ja-ko/fusioncore/slave/README.md

# Hello World Example

Starts a FreeRTOS task to print "Hello World"

See the README.md file in the upper level 'examples' directory for more information about examples.
