ja-ko/fusioncore/pcb/fusioncore.pdf

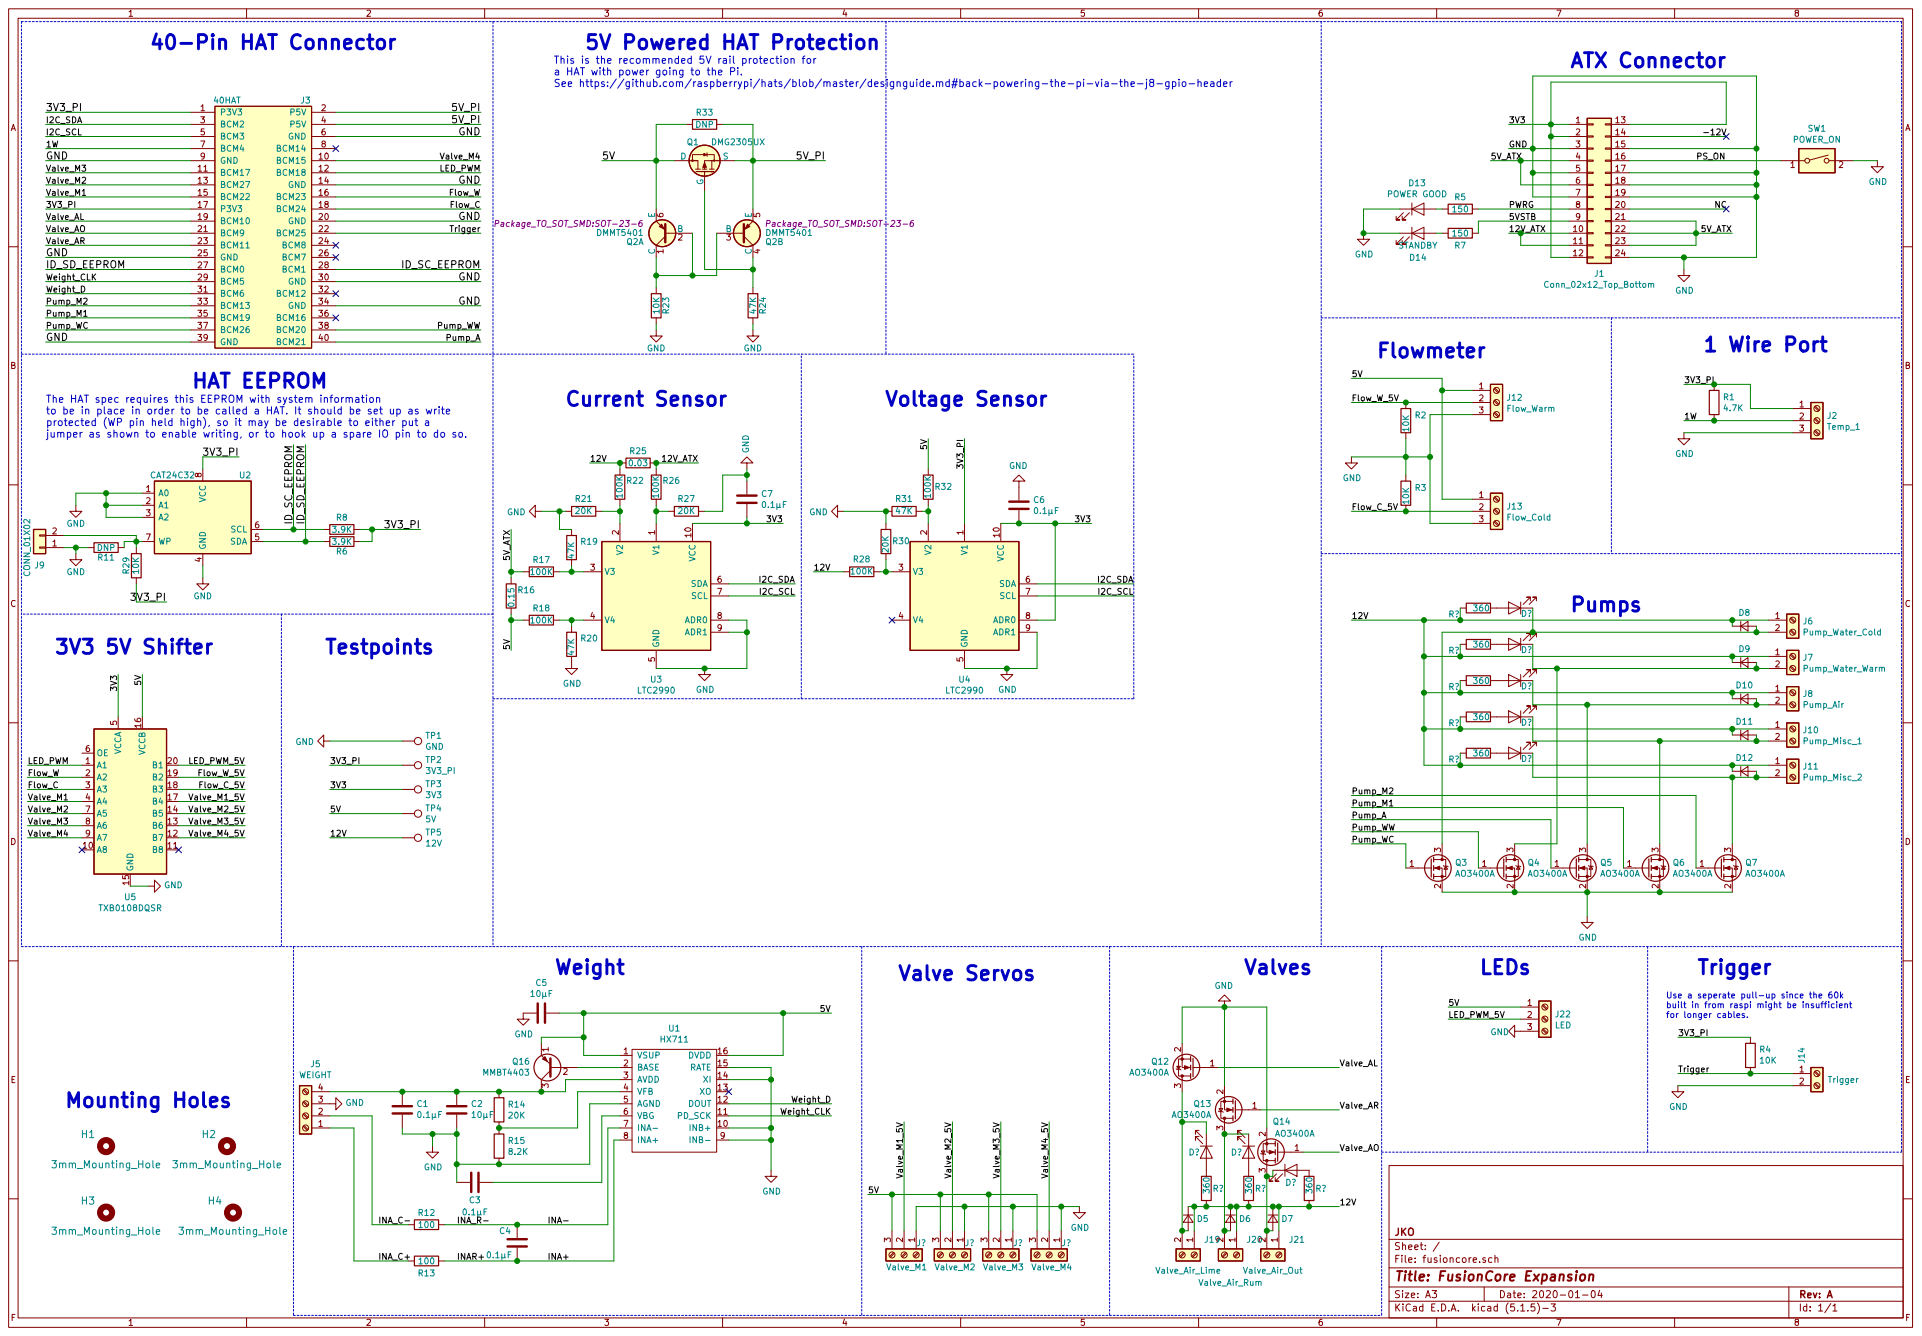
[picture p1: page 1]

This is the recommended 5V rail protection for
a HAT with power going to the Pi.
See https://github.com/raspberrypi/hats/blob/master/designguide.md#back-powering-the-pi-via-the-j8-gpio-header

The HAT spec requires this EEPROM with system information
to be in place in order to be called a HAT. It should be set up as write
protected (WP pin held high), so it may be desirable to either put a
jumper as shown to enable writing, or to hook up a spare IO pin to do so.

Use a seperate pull-up since the 60k
built in from raspi might be insufficient
for longer cables.
Trigger 3V3_PI

File: fusioncore.sch Sheet: / JKO

Id: 1/1 Title: FusionCore Expansion
