ja-ko/fusioncore/pcb/fusioncore.kicad_pcb

## KiCad design pcb/fusioncore.kicad_pcb (2020-06-07)

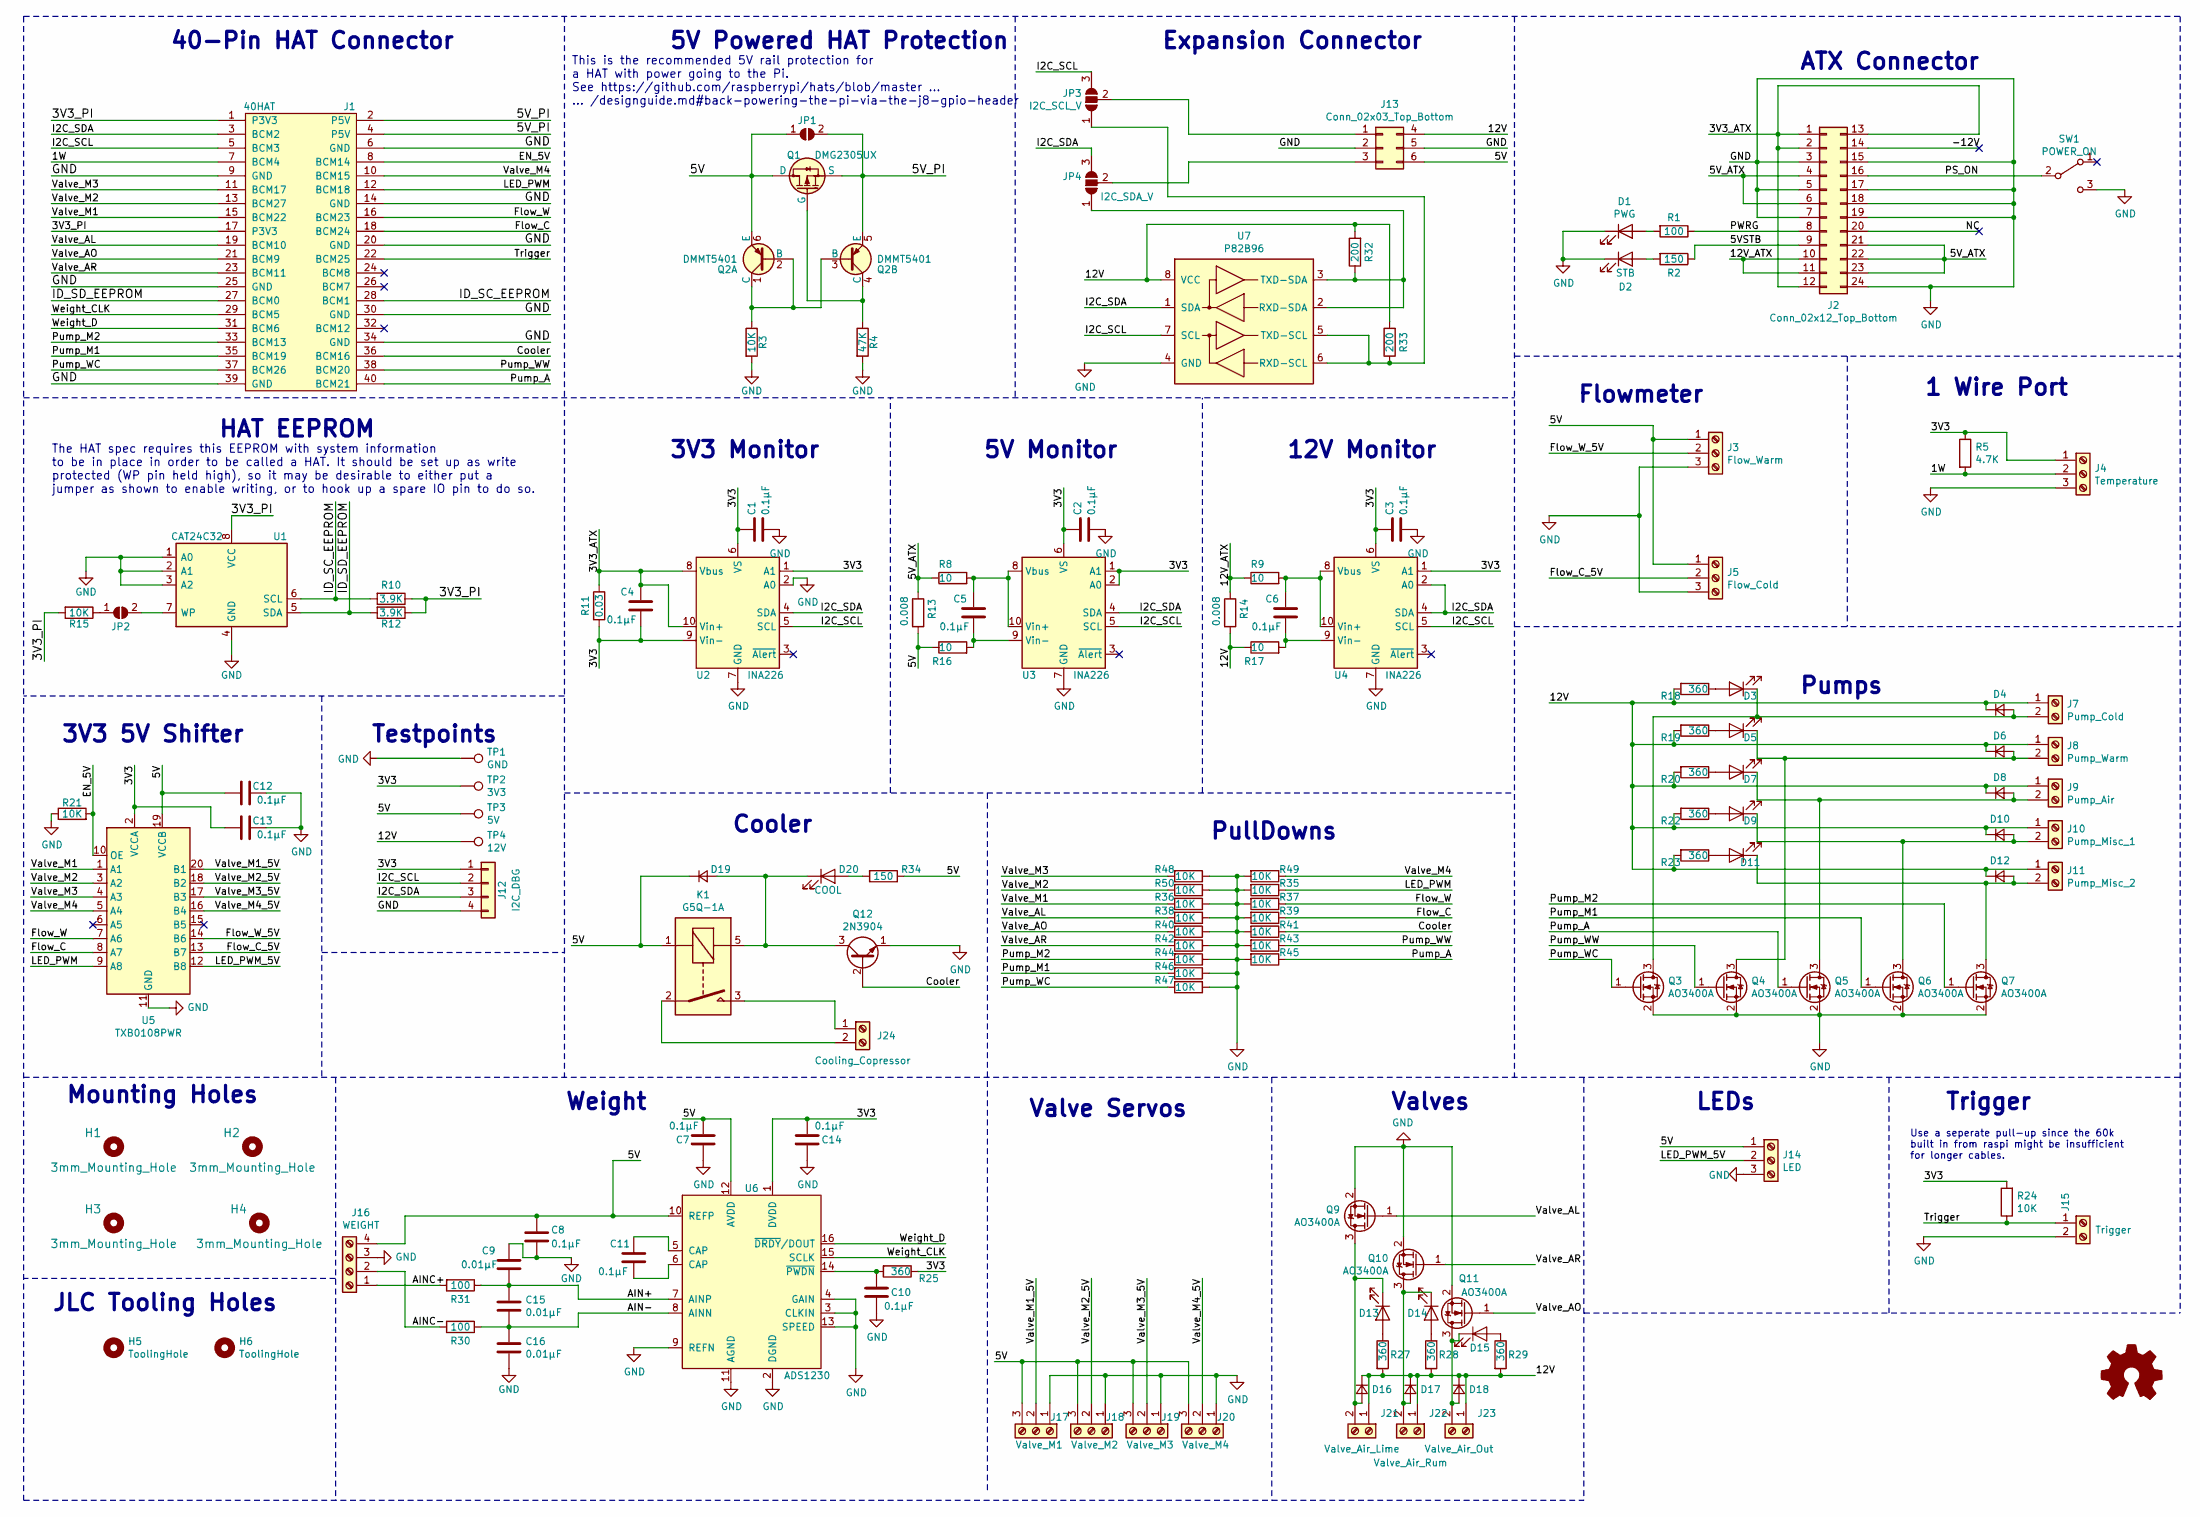
[picture p2: schematic fusioncore.sch, FusionCore Expansion]

Parts:
C1, C2, C3, C4, C5, C6, C7, C8, C10, C11, C12, C13, C14: 0.1μF; C_0805_2012Metric_Pad1.15x1.40mm_HandSolder; LCSC C49678
C9, C15, C16: 0.01μF; C_0402_1005Metric; LCSC C15195
D1: PWG; LED_0603_1608Metric_Pad1.05x0.95mm_HandSolder; LCSC C72043
D2: STB; LED_0805_2012Metric_Pad1.15x1.40mm_HandSolder; LCSC C2296
D3, D5, D7, D9, D11, D13, D14, D15: LED; LED_0603_1608Metric_Pad1.05x0.95mm_HandSolder; LCSC C72041
D4, D6, D8, D10, D12: D_Small; D_SMA; LCSC C22452
D16, D17, D18, D19: D; D_SMA; LCSC C22452
D20: COOL; LED_0805_2012Metric_Pad1.15x1.40mm_HandSolder; LCSC C2296
H1, H2, H3, H4: 3mm_Mounting_Hole; NPTH_3mm_ID
H5, H6: ToolingHole; JLC_Tooling_Hole
J1: 40HAT; PinSocket_2x20_P2.54mm_Vertical; Digikey 952-2150-ND‎
J2: Conn_02x12_Top_Bottom; Molex_Mini-Fit_Jr_5566-24A_2x12_P4.20mm_Vertical; Digikey WM3811-ND‎
J3: Flow_Warm; TerminalBlock_Phoenix_PT-1,5-3-5.0-H_1x03_P5.00mm_Horizontal; Digikey 277-1578-ND‎
J4: Temperature; TerminalBlock_Phoenix_PT-1,5-2-3.5-H_1x03_P3.50mm_Diagonal; Digikey 277-1780-ND
J5: Flow_Cold; TerminalBlock_Phoenix_PT-1,5-3-5.0-H_1x03_P5.00mm_Horizontal; Digikey 277-1578-ND‎
J7: Pump_Cold; TerminalBlock_Phoenix_PT-1,5-2-5.0-H_1x02_P5.00mm_Horizontal; Digikey 277-1667-ND
J8: Pump_Warm; TerminalBlock_Phoenix_PT-1,5-2-5.0-H_1x02_P5.00mm_Horizontal; Digikey 277-1667-ND
J9: Pump_Air; TerminalBlock_Phoenix_PT-1,5-2-5.0-H_1x02_P5.00mm_Horizontal; Digikey 277-1667-ND
J10: Pump_Misc_1; TerminalBlock_Phoenix_PT-1,5-2-5.0-H_1x02_P5.00mm_Horizontal; Digikey 277-1667-ND
J11: Pump_Misc_2; TerminalBlock_Phoenix_PT-1,5-2-5.0-H_1x02_P5.00mm_Horizontal; Digikey 277-1667-ND
J12: I2C_DBG; PinHeader_1x04_P2.54mm_Vertical; Digikey 732-5317-ND
J13: Conn_02x03_Top_Bottom; Molex_Micro-Fit_3.0_43045-0612_2x03_P3.00mm_Vertical; Digikey WM1791-ND
J14: LED; TerminalBlock_Phoenix_PT-1,5-3-5.0-H_1x03_P5.00mm_Horizontal; Digikey 277-1578-ND‎
J15: Trigger; TerminalBlock_Phoenix_PT-1,5-2-3.5-H_1x02_P3.50mm_Diagonal; Digikey 277-1779-ND
J16: WEIGHT; TerminalBlock_Phoenix_PT-1,5-4-5.0-H_1x04_P5.00mm_Horizontal
J17: Valve_M1; TerminalBlock_Phoenix_PT-1,5-3-5.0-H_1x03_P5.00mm_Horizontal; Digikey 277-1578-ND‎
J18: Valve_M2; TerminalBlock_Phoenix_PT-1,5-3-5.0-H_1x03_P5.00mm_Horizontal; Digikey 277-1578-ND‎
J19: Valve_M3; TerminalBlock_Phoenix_PT-1,5-3-5.0-H_1x03_P5.00mm_Horizontal; Digikey 277-1578-ND‎
J20: Valve_M4; TerminalBlock_Phoenix_PT-1,5-3-5.0-H_1x03_P5.00mm_Horizontal; Digikey 277-1578-ND‎
J21: Valve_Air_Lime; TerminalBlock_Phoenix_PT-1,5-2-5.0-H_1x02_P5.00mm_Horizontal; Digikey 277-1667-ND
J22: Valve_Air_Rum; TerminalBlock_Phoenix_PT-1,5-2-5.0-H_1x02_P5.00mm_Horizontal; Digikey 277-1667-ND
J23: Valve_Air_Out; TerminalBlock_Phoenix_PT-1,5-2-5.0-H_1x02_P5.00mm_Horizontal; Digikey 277-1667-ND
J24: Cooling_Copressor; TerminalBlock_Phoenix_PT-1,5-2-5.0-H_1x02_P5.00mm_Horizontal
JP1, JP2: SolderJumper_2_Open; SolderJumper-2_P1.3mm_Open_Pad1.0x1.5mm
JP3: I2C_SCL_V; SolderJumper-3_P1.3mm_Open_Pad1.0x1.5mm
JP4: I2C_SDA_V; SolderJumper-3_P1.3mm_Open_Pad1.0x1.5mm
K1: G5Q-1A; Relay_SPST_Omron-G5Q-1A; Digikey ‎Z6367-ND‎
Q1: DMG2305UX; SOT-23; LCSC C144153
Q2: DMMT5401; SOT-23-6_Handsoldering; LCSC C154733
Q3, Q4, Q5, Q6, Q7, Q9, Q10, Q11: AO3400A; SOT-23; LCSC C20917
Q12: 2N3904; SOT-23; LCSC C18536
R1, R30, R31: 100; R_0805_2012Metric_Pad1.15x1.40mm_HandSolder; LCSC C17408
R2, R34: 150; R_0805_2012Metric_Pad1.15x1.40mm_HandSolder; LCSC C17471
R3, R15, R21, R24: 10K; R_0805_2012Metric_Pad1.15x1.40mm_HandSolder; LCSC C17414
R4: 47K; R_0805_2012Metric_Pad1.15x1.40mm_HandSolder; LCSC C17713
R5: 4.7K; R_0805_2012Metric_Pad1.15x1.40mm_HandSolder; LCSC C17673
R8, R9, R16, R17: 10; R_0805_2012Metric_Pad1.15x1.40mm_HandSolder; LCSC C17415
R10, R12: 3.9K; R_0805_2012Metric_Pad1.15x1.40mm_HandSolder; LCSC C17614
R11: 0.03; R_0805_2012Metric_Pad1.15x1.40mm_HandSolder; LCSC C247605
R13, R14: 0.008; R_2512_6332Metric_Pad1.52x3.35mm_HandSolder; LCSC C76241
R18, R19, R20, R22, R23, R25, R27, R28, R29: 360; R_0603_1608Metric_Pad1.05x0.95mm_HandSolder; LCSC C25194
R32, R33: 200; R_0805_2012Metric_Pad1.15x1.40mm_HandSolder; LCSC C17540
R35, R36, R37, R38, R39, R40, R41, R42, R43, R44, R45, R46, R47, R48, R49, R50: 10K; R_0402_1005Metric; LCSC C25744
SW1: POWER_ON; SW_CuK_JS202011CQN_DPDT_Straight; Digikey 401-2001-ND
TP1: GND; TestPoint_THTPad_D2.0mm_Drill1.0mm
TP2: 3V3; TestPoint_THTPad_D2.0mm_Drill1.0mm
TP3: 5V; TestPoint_THTPad_D2.0mm_Drill1.0mm
TP4: 12V; TestPoint_THTPad_D2.0mm_Drill1.0mm
U1: CAT24C32; SOIC-8_3.9x4.9mm_P1.27mm; LCSC C81193
U2, U3, U4: INA226; VSSOP-10_3x3mm_P0.5mm; LCSC C49851
U5: TXB0108PWR; TSSOP-20_4.4x6.5mm_P0.65mm; LCSC C53406
U6: ADS1230; TSSOP-16_4.4x5mm_P0.65mm; LCSC C58052
U7: P82B96; SOIC-8_3.9x4.9mm_P1.27mm; LCSC C32103

Connections:
/1W: J1.7 (BCM4), J4.2, R5.2
/3V3: C1.2, C2.2, C3.2, C4.1, C13.2, C14.2, J4.1, J12.1, R5.1, R11.2, R24.2, R25.1, TP2.1, U2.1 (A1), U2.6 (VS), U2.9 (Vin-), U3.1 (A1), U3.2 (A0), U3.6 (VS), U4.1 (A1), U4.6 (VS), U5.2 (VCCA), U6.1 (DVDD)
/3V3_ATX: C4.2, J2.1, J2.2, J2.12, J2.13, R11.1, U2.8 (Vbus), U2.10 (Vin+)
/3V3_PI: J1.1 (P3V3), J1.17 (P3V3), R10.1, R12.1, R15.2, U1.8 (VCC)
/5V: C7.2, C8.2, C12.2, D19.1 (K), J3.1, J5.1, J13.6, J14.1, J16.4, J17.3, J18.3, J19.3, J20.3, JP1.1 (A), K1.1, Q1.3 (D), Q2.6 (E), R13.2, R16.1, R34.1, TP3.1, U5.19 (VCCB), U6.10 (REFP), U6.12 (AVDD)
/5VSTB: J2.9, R2.1
/5V_ATX: J2.4, J2.6, J2.21, J2.22, J2.23, R8.1, R13.1
/5V_PI: J1.2 (P5V), J1.4 (P5V), JP1.2 (B), Q1.2 (S), Q2.5 (E)
/12V: D4.1 (K), D6.1 (K), D8.1 (K), D10.1 (K), D12.1 (K), D16.1 (K), D17.1 (K), D18.1 (K), J7.1, J8.1, J9.1, J10.1, J11.1, J13.4, J21.1, J22.1, J23.1, R14.2, R17.1, R18.2, R19.2, R20.2, R22.2, R23.2, R27.2, R28.2, R29.2, R32.2, R33.2, TP4.1, U7.8 (VCC)
/12V_ATX: J2.10, J2.11, R9.1, R14.1
/AIN+: C9.1, C15.2, R31.1, U6.7 (AINP)
/AIN-: C15.1, C16.2, R30.1, U6.8 (AINN)
/AINC+: J16.1, R31.2
/AINC-: J16.2, R30.2
/Cooler: J1.36 (BCM16), Q12.2 (B), R41.1
/EN_5V: J1.8 (BCM14), R21.2, U5.10 (OE)
/Flow_C: J1.18 (BCM24), R39.1, U5.8 (A7)
/Flow_C_5V: J5.2, U5.13 (B7)
/Flow_W: J1.16 (BCM23), R37.1, U5.7 (A6)
/Flow_W_5V: J3.2, U5.14 (B6)
/I2C_SCL: J1.5 (BCM3), J12.2, JP3.3 (B), U2.5 (SCL), U3.5 (SCL), U4.5 (SCL), U7.7 (SCL)
/I2C_SDA: J1.3 (BCM2), J12.3, JP4.3 (B), U2.4 (SDA), U3.4 (SDA), U4.2 (A0), U4.4 (SDA), U7.1 (SDA)
/ID_SC_EEPROM: J1.28 (BCM1), R10.2, U1.6 (SCL)
/ID_SD_EEPROM: J1.27 (BCM0), R12.2, U1.5 (SDA)
/LED_PWM: J1.12 (BCM18), R35.1, U5.9 (A8)
/LED_PWM_5V: J14.2, U5.12 (B8)
/PS_ON: J2.16, SW1.2 (B)
/PWRG: J2.8, R1.1
/Pump_A: J1.40 (BCM21), Q5.1 (G), R45.1
/Pump_M1: J1.35 (BCM19), Q6.1 (G), R46.2
/Pump_M2: J1.33 (BCM13), Q7.1 (G), R44.2
/Pump_WC: J1.37 (BCM26), Q3.1 (G), R47.2
/Pump_WW: J1.38 (BCM20), Q4.1 (G), R43.1
/Trigger: J1.22 (BCM25), J15.1, R24.1
/Valve_AL: J1.19 (BCM10), Q9.1 (G), R38.2
/Valve_AO: J1.21 (BCM9), Q11.1 (G), R40.2
/Valve_AR: J1.23 (BCM11), Q10.1 (G), R42.2
/Valve_M1: J1.15 (BCM22), R36.2, U5.1 (A1)
/Valve_M1_5V: J17.2, U5.20 (B1)
/Valve_M2: J1.13 (BCM27), R50.2, U5.3 (A2)
/Valve_M2_5V: J18.2, U5.18 (B2)
/Valve_M3: J1.11 (BCM17), R48.2, U5.4 (A3)
/Valve_M3_5V: J19.2, U5.17 (B3)
/Valve_M4: J1.10 (BCM15), R49.1, U5.5 (A4)
/Valve_M4_5V: J20.2, U5.16 (B4)
/Weight_CLK: J1.29 (BCM5), U6.15 (SCLK)
/Weight_D: J1.31 (BCM6), U6.16 (~DRDY~/DOUT)
GND: C1.1, C2.1, C3.1, C7.1, C8.1, C9.2, C10.1, C12.1, C13.1, C14.1, C16.1, D1.1 (K), D2.1 (K), J1.6 (GND), J1.9 (GND), J1.14 (GND), J1.20 (GND), J1.25 (GND), J1.30 (GND), J1.34 (GND), J1.39 (GND), J2.3, J2.5, J2.7, J2.15, J2.17, J2.18, J2.19, J2.24, J3.3, J4.3, J5.3, J12.4, J13.2, J13.5, J14.3, J15.2, J16.3, J17.1, J18.1, J19.1, J20.1, Q3.2 (S), Q4.2 (S), Q5.2 (S), Q6.2 (S), Q7.2 (S), Q9.2 (S), Q10.2 (S), Q11.2 (S), Q12.1 (E), R3.2, R4.2, R21.1, R35.2, R36.1, R37.2, R38.1, R39.2, R40.1, R41.2, R42.1, R43.2, R44.1, R45.2, R46.1, R47.1, R48.1, R49.2, R50.1, SW1.3 (C), TP1.1, U1.1 (A0), U1.2 (A1), U1.3 (A2), U1.4 (GND), U2.2 (A0), U2.7 (GND), U3.7 (GND), U4.7 (GND), U5.11 (GND), U6.2 (DGND), U6.3 (CLKIN), U6.4 (GAIN), U6.9 (REFN), U6.11 (AGND), U6.13 (SPEED), U7.4 (GND)
unnamed: C5.1, R16.2, U3.9 (Vin-)
unnamed: C5.2, R8.2, U3.8 (Vbus), U3.10 (Vin+)
unnamed: C6.1, R17.2, U4.9 (Vin-)
unnamed: C6.2, R9.2, U4.8 (Vbus), U4.10 (Vin+)
unnamed: C10.2, R25.2, U6.14 (~PWDN)
unnamed: C11.1, U6.5 (CAP)
unnamed: C11.2, U6.6 (CAP)
unnamed: D1.2 (A), R1.2
unnamed: D2.2 (A), R2.2
unnamed: D3.1 (K), D4.2 (A), J7.2, Q3.3 (D)
unnamed: D3.2 (A), R18.1
unnamed: D5.1 (K), D6.2 (A), J8.2, Q4.3 (D)
unnamed: D5.2 (A), R19.1
unnamed: D7.1 (K), D8.2 (A), J9.2, Q5.3 (D)
unnamed: D7.2 (A), R20.1
unnamed: D9.2 (A), R22.1
unnamed: D9.1 (K), D10.2 (A), J10.2, Q6.3 (D)
unnamed: D11.1 (K), D12.2 (A), J11.2, Q7.3 (D)
unnamed: D11.2 (A), R23.1
unnamed: D13.1 (K), D16.2 (A), J21.2, Q9.3 (D)
unnamed: D13.2 (A), R27.1
unnamed: D14.1 (K), D17.2 (A), J22.2, Q10.3 (D)
unnamed: D14.2 (A), R28.1
unnamed: D15.1 (K), D18.2 (A), J23.2, Q11.3 (D)
unnamed: D15.2 (A), R29.1
unnamed: D19.2 (A), D20.1 (K), K1.5, Q12.3 (C)
unnamed: D20.2 (A), R34.2
unnamed: J13.1, JP3.2 (C)
unnamed: J13.3, JP4.2 (C)
unnamed: J24.1, K1.3
unnamed: J24.2, K1.2
unnamed: JP2.1 (A), R15.1
unnamed: JP2.2 (B), U1.7 (WP)
unnamed: JP3.1 (A), R33.1, U7.5 (TXD-SCL), U7.6 (RXD-SCL)
unnamed: JP4.1 (A), R32.1, U7.2 (RXD-SDA), U7.3 (TXD-SDA)
unnamed: Q1.1 (G), Q2.4 (C), R4.1
unnamed: Q2.1 (C), Q2.2 (B), Q2.3 (B), R3.1

Notes on the sheet:
5V Powered HAT Protection
This is the recommended 5V rail protection for a HAT with power going to the Pi. See https://github.com/raspberrypi/hats/blob/master ... ... /designguide.md#back-powering-the-pi-via-the-j8-gpio-header
HAT EEPROM
Mounting Holes
40-Pin HAT Connector
The HAT spec requires this EEPROM with system information to be in place in order to be called a HAT. It should be set up as write protected (WP pin held high), so it may be desirable to either put a jumper as shown to enable writing, or to hook up a spare IO pin to do so.
ATX Connector
1 Wire Port
Pumps
Valves
LEDs
Flowmeter
Weight
Use a seperate pull-up since the 60k built in from raspi might be insufficient for longer cables.
Trigger
3V3 Monitor
Testpoints
3V3 5V Shifter
Valve Servos
Expansion Connector
JLC Tooling Holes
5V Monitor
12V Monitor
Cooler
PullDowns

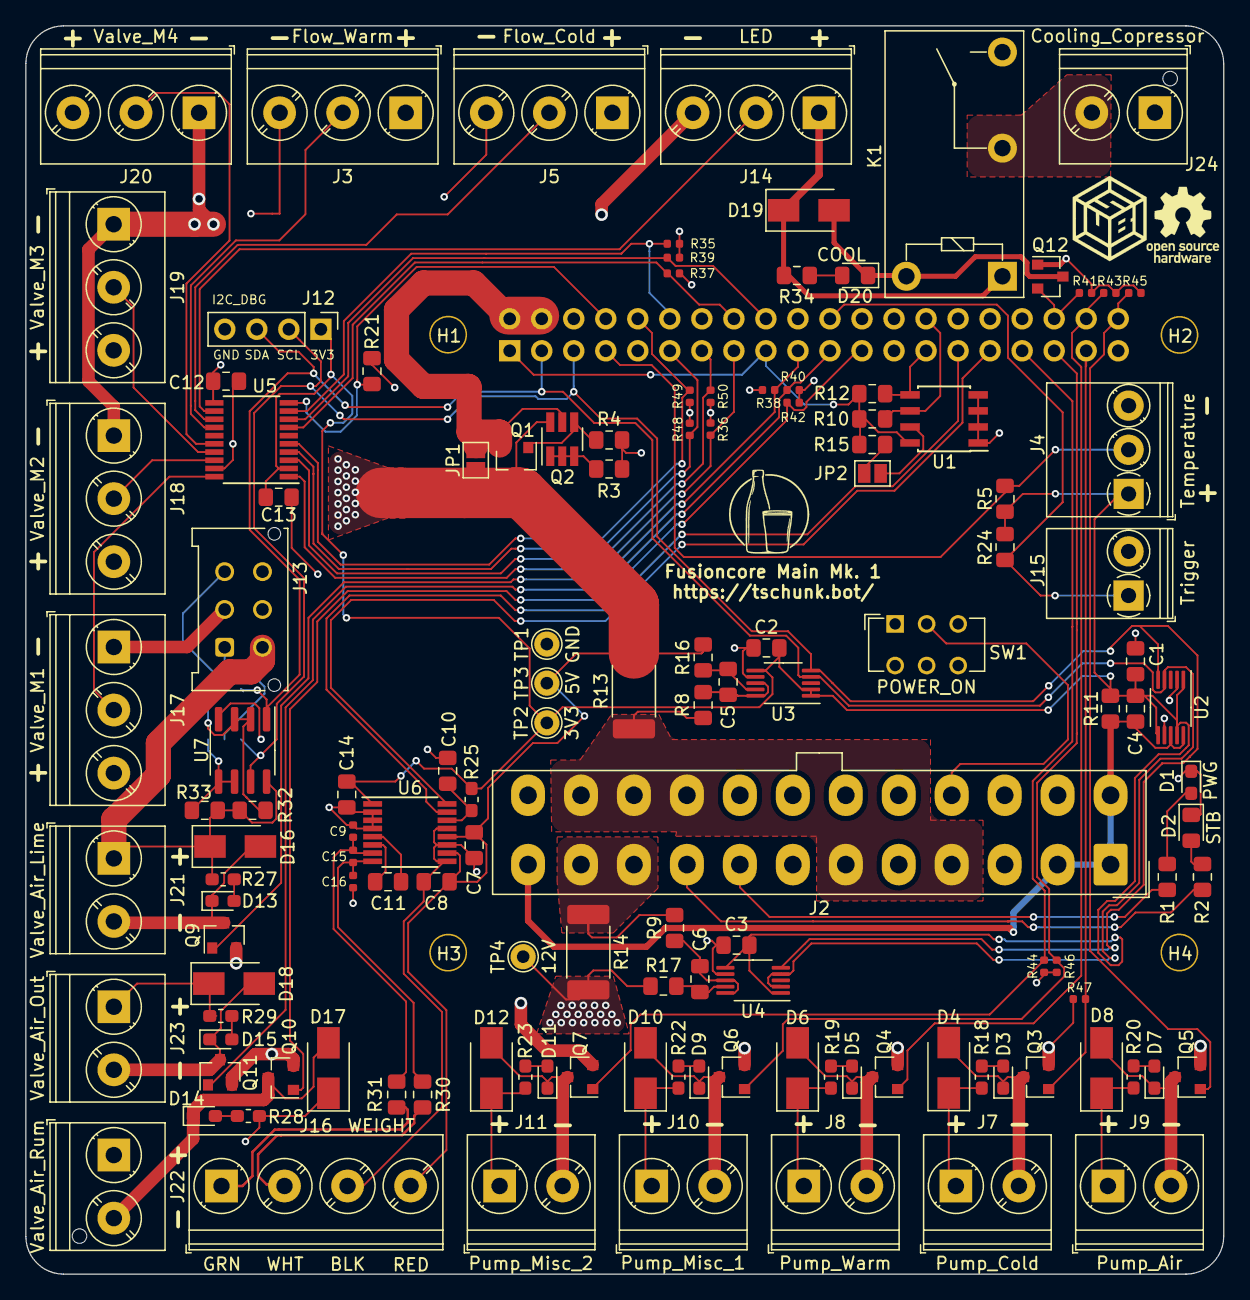
[picture p3: board fusioncore.kicad_pcb from above]

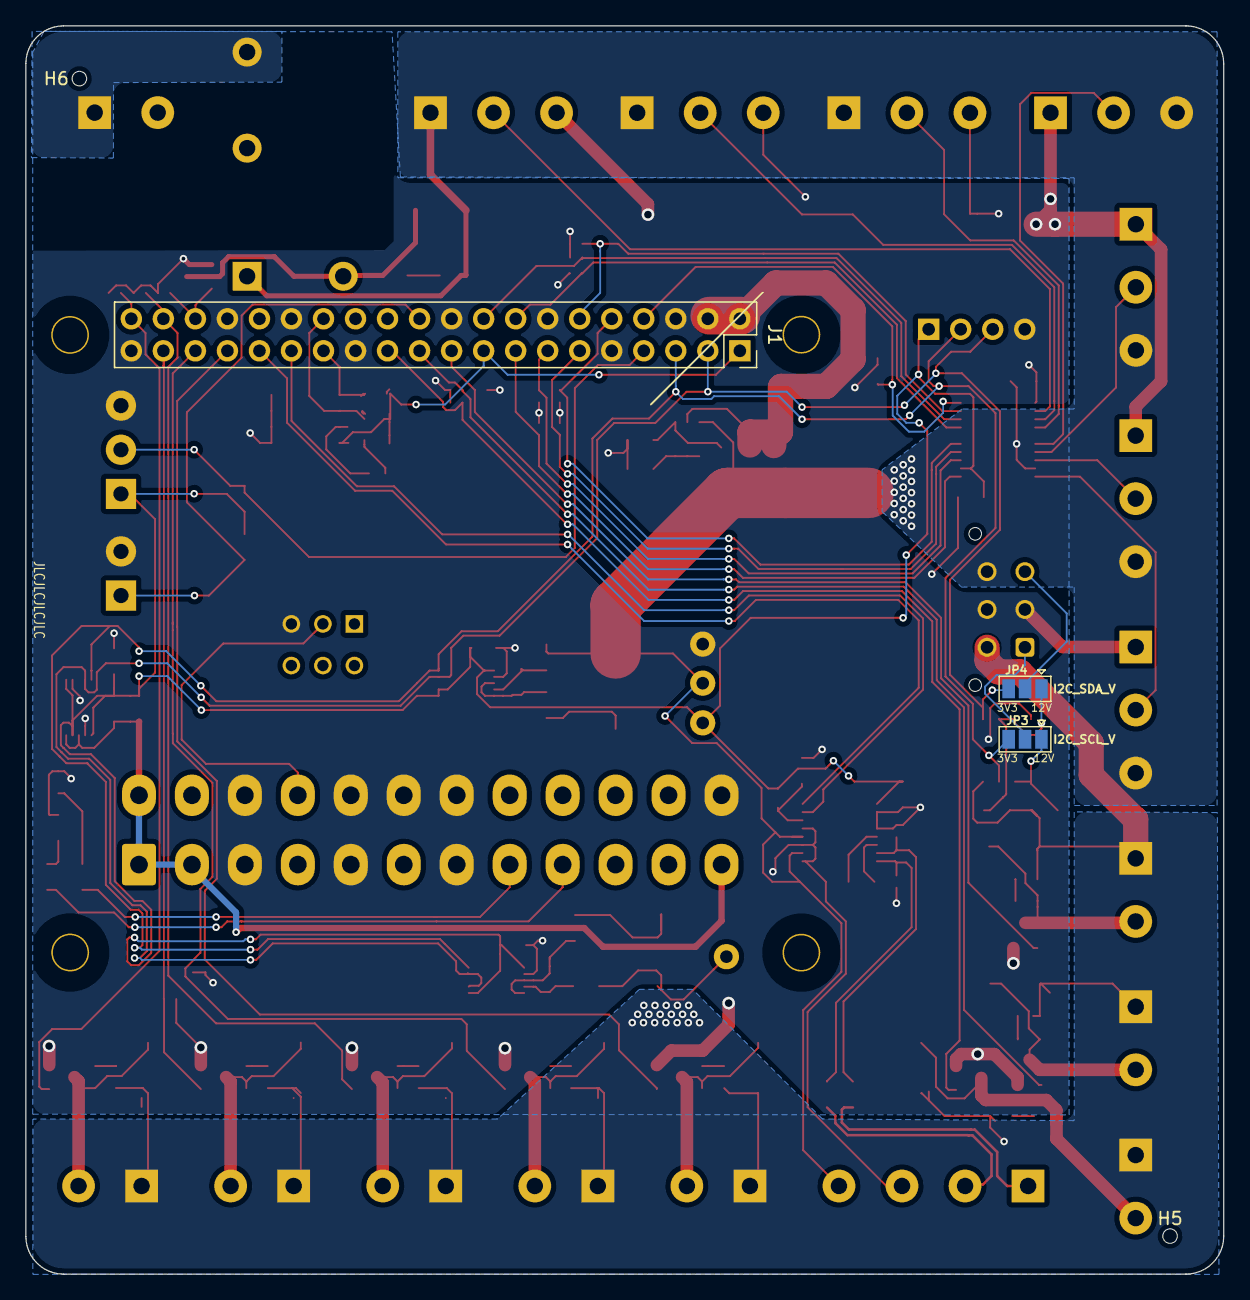
[picture p4: board fusioncore.kicad_pcb from below]

Board: 2 copper layers, 95.0 x 99.0 mm, 140 parts (5 on the bottom side), 85 nets.
