ja-ko/fusioncore/(commit log)

2019-12-16 First simple I2C master side
2020-01-05 Added WIP pcb
    [fusioncore.kicad_pcb, fusioncore.sch]
2020-01-08 Working on PCB schematic
    [fusioncore.sch]
2020-01-12 Working on the layout of pcb
    [fusioncore.kicad_pcb, fusioncore.sch]
2020-01-13 Almost done with PCB
    [fusioncore.kicad_pcb, fusioncore.sch]
2020-01-13 Changed Hx711 transistor
    [fusioncore.kicad_pcb, fusioncore.sch]
2020-01-13 Minor stuff.
    [fusioncore.kicad_pcb]
2020-01-13 Increased the number of vias for 12V power supply
    [fusioncore.kicad_pcb]
2020-01-13 Fixed component sizes and rearranged components to match spec
    [fusioncore.kicad_pcb, fusioncore.sch]
2020-01-13 Added LSCS part numbers
    [fusioncore.sch]
2020-01-26 Minor PCB fixes.
    [fusioncore.kicad_pcb, fusioncore.sch]
2020-01-26 Added logic level shifter to schema only.
    [fusioncore.sch]
2020-01-26 Organize the schema
    [fusioncore.sch]
2020-01-26 Working on replacing some 2-Port Valves
    [fusioncore.kicad_pcb, fusioncore.sch]
2020-01-31 Finalized current PCB iteration
    [fusioncore.kicad_pcb, fusioncore.sch]
2020-01-31 Fixed some more issues on pcb
    [fusioncore.kicad_pcb, fusioncore.sch]
2020-01-31 Fixed minor issues
    [fusioncore.kicad_pcb]
2020-01-31 Added more debug and expansion connectors
    [fusioncore.kicad_pcb, fusioncore.sch]
2020-01-31 Added JLC specific marker
    [fusioncore.kicad_pcb, fusioncore.sch]
2020-01-31 Fix J23
    [fusioncore.kicad_pcb, fusioncore.sch]
2020-01-31 Fix some alignments
    [fusioncore.kicad_pcb]
2020-01-31 Fix clearances of JLC tooling holes
    [fusioncore.kicad_pcb]
2020-02-01 Replaced LTC2990 with INA226 in schema
    [fusioncore.sch]
2020-02-01 Replaced LTC2990 with INA226 on pcb layout as well
    [fusioncore.kicad_pcb, fusioncore.sch]
2020-02-01 Cleaned up annotations
    [fusioncore.kicad_pcb, fusioncore.sch]
2020-02-01 Fixed some alignment issues
    [fusioncore.kicad_pcb]
2020-02-01 Set I2C Address for INA226s
    [fusioncore.kicad_pcb, fusioncore.sch]
2020-02-01 Fixed some more alignment issues
    [fusioncore.kicad_pcb]
2020-02-02 Added license
    [fusioncore.kicad_pcb]
2020-02-02 Added a P82B96TD for external HighVoltage I2C
    [fusioncore.kicad_pcb, fusioncore.sch]
2020-02-06 Fixed some minor alignment issues
    [fusioncore.kicad_pcb, fusioncore.sch]
2020-02-08 Fixed issues from review.
    Swapped diodes for Schottky diodes.
    Changed logic level from HX711 to 3V3
    Moved OE from 5V shifter to raspberry pi.
    [fusioncore.kicad_pcb, fusioncore.sch]
2020-02-08 Simplified the EEPROM by removing an unecessary jumper
    [fusioncore.kicad_pcb, fusioncore.sch]
2020-02-17 Added B+/- weight connector
    [fusioncore.kicad_pcb, fusioncore.sch]
2020-03-01 Added relais for cooling compressor
    [fusioncore.kicad_pcb, fusioncore.sch]
2020-03-10 Added Relais to board
    [fusioncore.kicad_pcb, fusioncore.sch]
2020-03-10 Simplified some layouts
    [fusioncore.kicad_pcb]
2020-03-10 Moved some labels
    [fusioncore.kicad_pcb]
2020-03-10 Moved some components
    [fusioncore.kicad_pcb]
2020-03-10 Added subraum logo
    [fusioncore.kicad_pcb]
2020-03-11 Added and moved some capacitors
    [fusioncore.kicad_pcb, fusioncore.sch]
2020-03-12 Added LCSC for R30/R31
    [fusioncore.sch]
2020-03-13 Added jumper to allow switching I2C voltage on expansion connector.
    [fusioncore.kicad_pcb, fusioncore.sch]
2020-03-13 Added labels for I2C Voltage jumper
    [fusioncore.kicad_pcb]
2020-03-14 Replaces HX711 with ADS1230
    [fusioncore.kicad_pcb, fusioncore.sch]
2020-03-21 Changed Q2 footprint to handsoldered
    [fusioncore.kicad_pcb, fusioncore.sch]
2020-03-21 Added missing digikey article numbers
    [fusioncore.sch]
2020-03-21 Ordered for assembly. Rev A
    [bom.csv, digikey-bom.csv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]
2020-06-07 Started working on Rev B.
    Adds pull-down for MOSFETs. During actual use these are not required.
    However these pull-downs make sure that the MOSFETs can't be damaged
    even when there is no raspberry connected to the board.
    Fixes footprint of U5. Rev A assumed a different pin mapping than the
    actual placed component, so U5 can't be used in Rev A. This fixes the
    pin mapping and reroutes some traces accordingly.
    Increases the distance between the two 230V planes at J24. While the old
    design should work there were some concerns regarding the possibility of
    a flashover under some circumstances.
    [fusioncore.kicad_pcb, fusioncore.sch]
